TheTesla/LT3060module/LT3060boardTEST/LT3060boardTEST.kicad_pcb

## KiCad design LT3060boardTEST/LT3060boardTEST.kicad_pcb (2014-09-18)

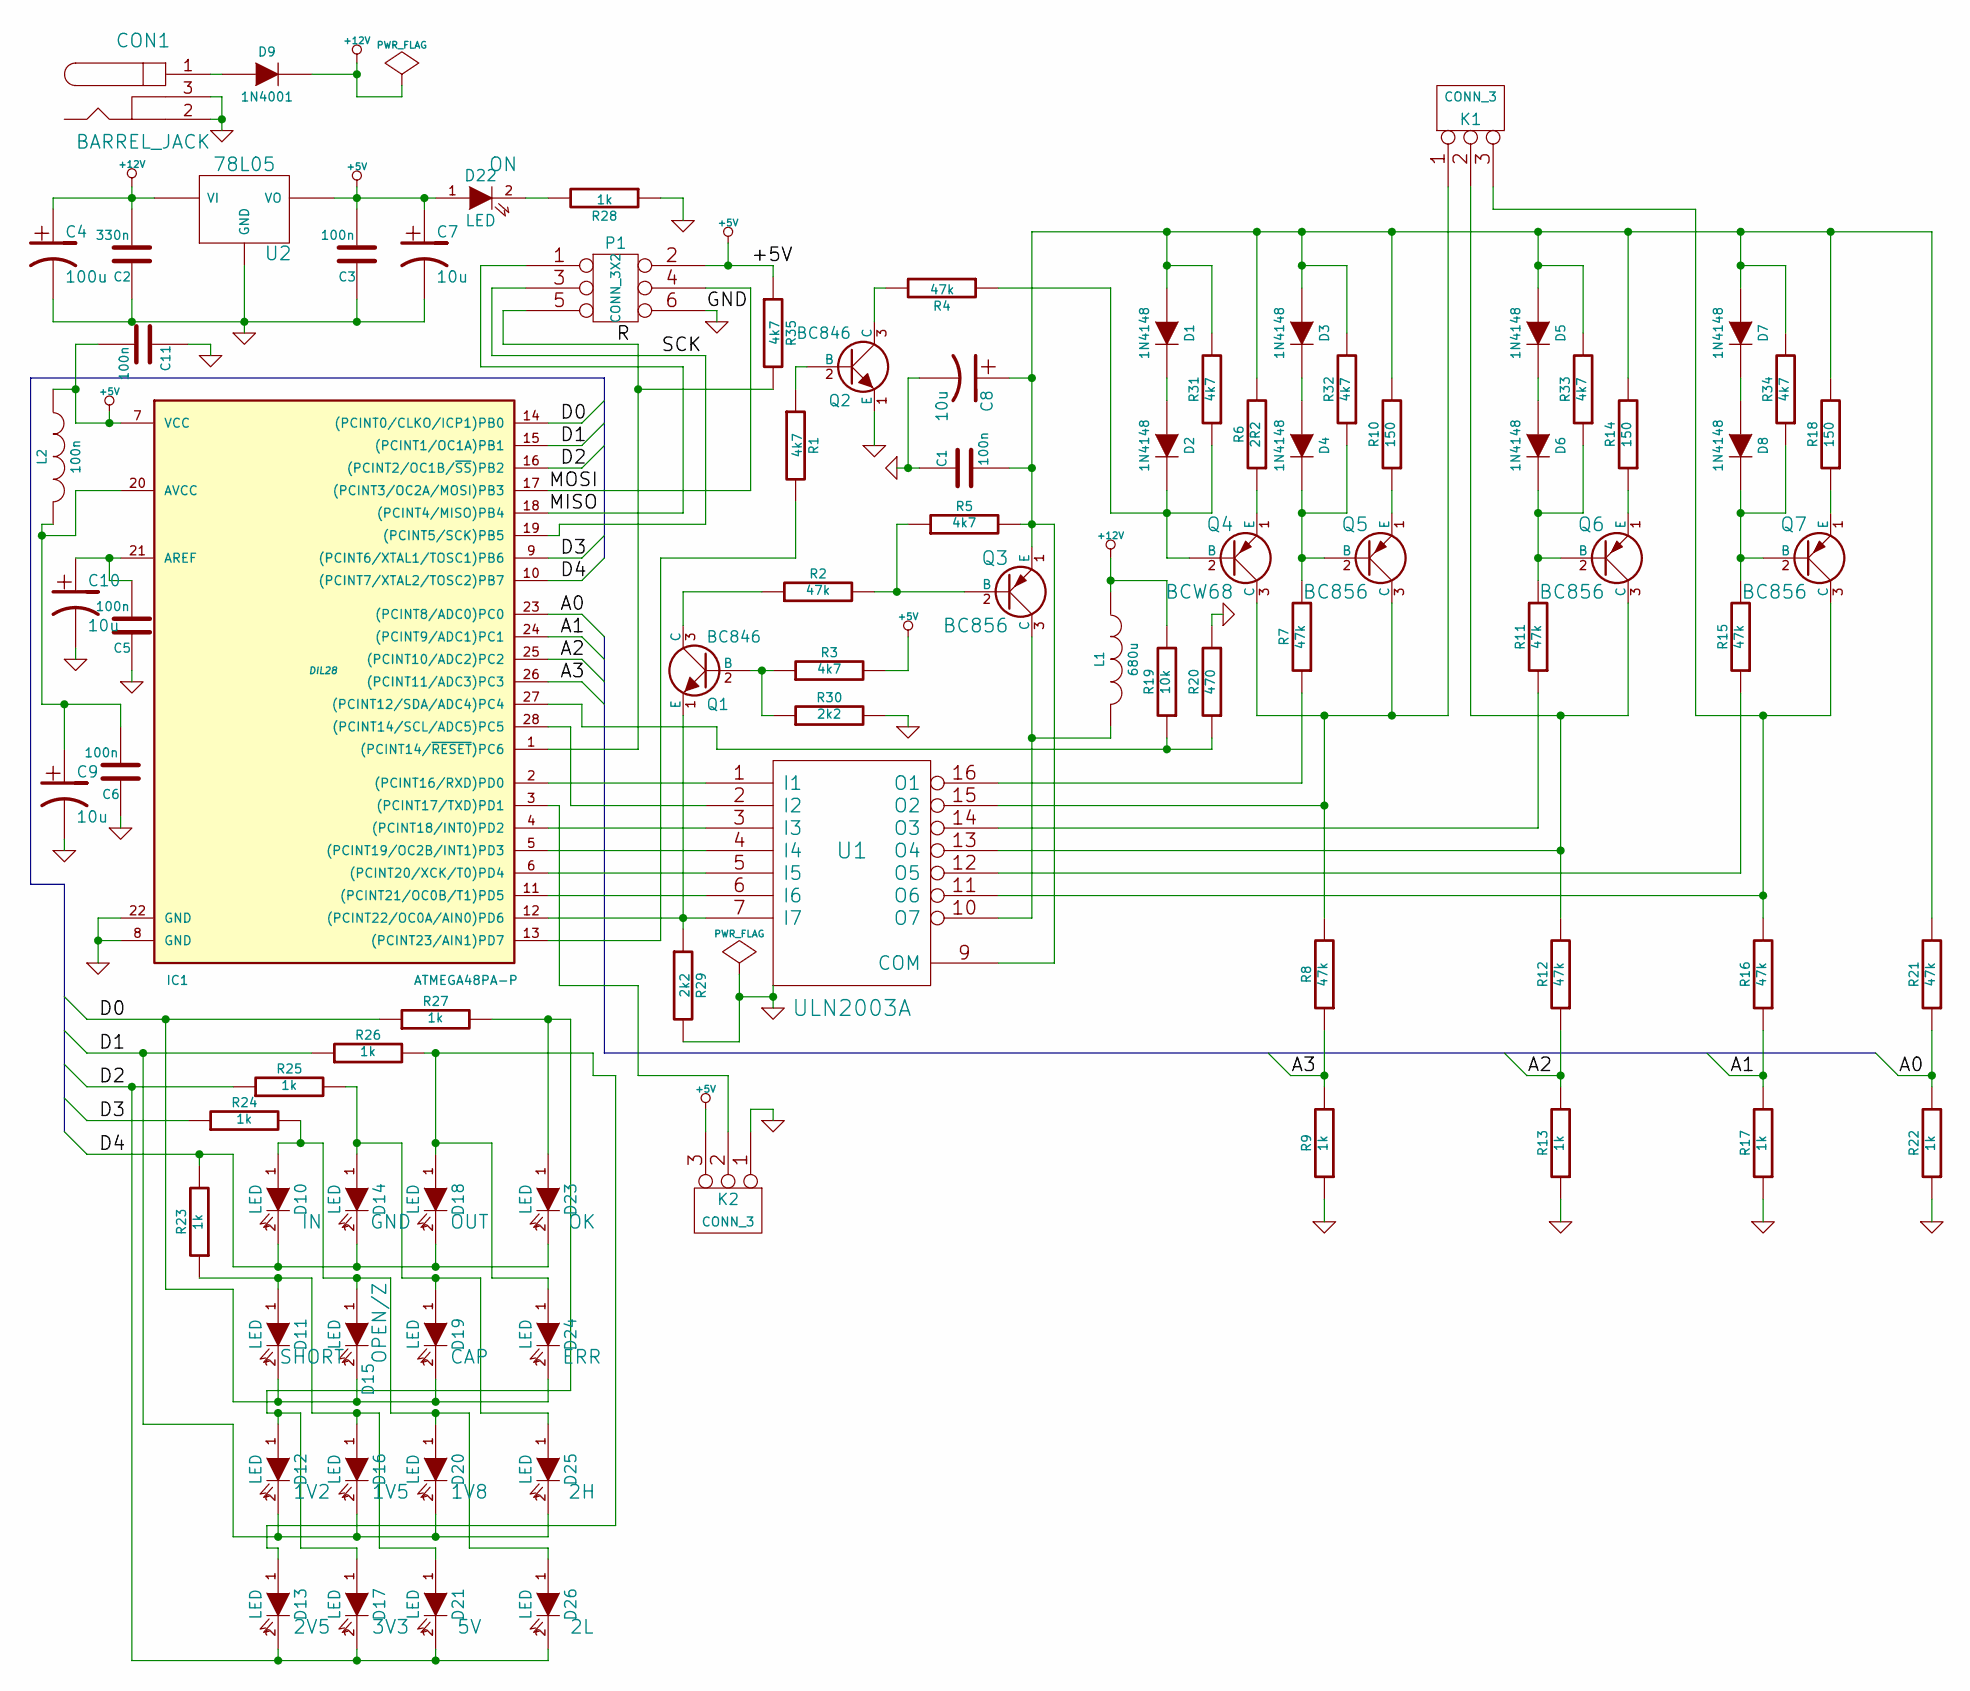
[picture p1: schematic LT3060boardTEST.sch]

Parts:
C1: 100n; Voltage 63
C2: 330n
C3, C5, C6, C11: 100n
C4: 100u
C7, C9, C10: 10u
C8: 10u; Voltage 63
CON1: BARREL_JACK
D1, D2, D3, D4, D5, D6, D7, D8: 1N4148
D9: 1N4001
D10, D11, D12, D13, D14, D15, D16, D17, D18, D19, D20, D21, D22, D23, D24, D25, D26: LED
IC1: ATMEGA48PA-P; DIL28
K1, K2: CONN_3
L1: 680u
L2: 100n
P1: CONN_3X2
Q1, Q2: BC846
Q3, Q5, Q6, Q7: BC856
Q4: BCW68
R1, R3, R5, R31, R32, R33, R34, R35: 4k7
R2, R4, R7, R8, R11, R12, R15, R16, R21: 47k
R6: 2R2
R9, R13, R17, R22, R23, R24, R25, R26, R27, R28: 1k
R10, R14, R18: 150
R19: 10k
R20: 470
R29, R30: 2k2
U1: ULN2003A
U2: 78L05

Connections:
+5V: C3.2, C7.1, C11.2, D22.1 (A), IC1.7 (VCC), K2.3, L2.1, P1.2, R3.2, R35.1, U2.VO
+12V: C2.2, C4.1, D9.2 (K), L1.1, R19.2, U2.VI
/A0: IC1.23 ((PCINT8/ADC0)PC0), R21.1, R22.2
/A1: IC1.24 ((PCINT9/ADC1)PC1), R16.1, R17.2
/A2: IC1.25 ((PCINT10/ADC2)PC2), R12.1, R13.2
/A3: IC1.26 ((PCINT11/ADC3)PC3), R8.1, R9.2
/D0: D11.2 (K), D15.2 (K), D19.2 (K), D24.2 (K), IC1.14 ((PCINT0/CLKO/ICP1)PB0), R27.1
/D1: D12.2 (K), D16.2 (K), D20.2 (K), D25.2 (K), IC1.15 ((PCINT1/OC1A)PB1), R26.1
/D2: D13.2 (K), D17.2 (K), D21.2 (K), D26.2 (K), IC1.16 ((PCINT2/OC1B/~SS~)PB2), R25.1
/D3: IC1.9 ((PCINT6/XTAL1/TOSC1)PB6), R24.1
/D4: D10.2 (K), D14.2 (K), D18.2 (K), D23.2 (K), IC1.10 ((PCINT7/XTAL2/TOSC2)PB7), R23.2
/MISO: IC1.18 ((PCINT4/MISO)PB4), P1.1
/MOSI: IC1.17 ((PCINT3/OC2A/MOSI)PB3), P1.4
/R: IC1.1 ((PCINT14/~RESET~)PC6), P1.5, R35.2
/SCK: IC1.19 ((PCINT5/SCK)PB5), P1.3
GND: C1.1, C2.1, C3.1, C4.2, C5.1, C6.1, C7.2, C8.2, C9.2, C10.2, C11.1, CON1.2, CON1.3, IC1.8 (GND), IC1.22 (GND), K2.1, P1.6, Q2.1 (E), R9.1, R13.1, R17.1, R20.2, R22.1, R28.1, R29.2, R30.2, U1.8 (GND), U2.GND
unnamed: D11.1 (A), D16.1 (A), D21.1 (A), R23.1
unnamed: D13.1 (A), D18.1 (A), D24.1 (A), R26.2
unnamed: D14.1 (A), D19.1 (A), D25.1 (A), R25.2
unnamed: D10.1 (A), D15.1 (A), D20.1 (A), D26.1 (A), R24.2
unnamed: IC1.27 ((PCINT12/SDA/ADC4)PC4), R19.1, R20.1
unnamed: D12.1 (A), D17.1 (A), D23.1 (A), R27.2
unnamed: IC1.3 ((PCINT17/TXD)PD1), K2.2 (PM)
unnamed: C5.2, C10.1, IC1.21 (AREF)
unnamed: IC1.28 ((PCINT14/SCL/ADC5)PC5), U1.2 (I2)
unnamed: C6.2, C9.1, IC1.20 (AVCC), L2.2
unnamed: CON1.1, D9.1 (A)
unnamed: D22.2 (K), R28.2
unnamed: IC1.2 ((PCINT16/RXD)PD0), U1.1 (I1)
unnamed: IC1.13 ((PCINT23/AIN1)PD7), R1.2
unnamed: Q3.2 (B), R2.2, R5.1
unnamed: Q1.3 (C), R2.1
unnamed: D2.2 (K), Q4.2 (B), R4.1, R31.1
unnamed: IC1.4 ((PCINT18/INT0)PD2), U1.3 (I3)
unnamed: IC1.5 ((PCINT19/OC2B/INT1)PD3), U1.4 (I4)
unnamed: IC1.6 ((PCINT20/XCK/T0)PD4), U1.5 (I5)
unnamed: IC1.11 ((PCINT21/OC0B/T1)PD5), U1.6 (I6)
unnamed: Q1.2 (B), R3.1, R30.1
unnamed: D5.2 (K), D6.1 (A)
unnamed: D7.2 (K), D8.1 (A)
unnamed: Q4.1 (E), R6.1
unnamed: D1.2 (K), D2.1 (A)
unnamed: Q2.2 (B), R1.1
unnamed: Q2.3 (C), R4.2
unnamed: D8.2 (K), Q7.2 (B), R15.2, R34.1
unnamed: R7.1, U1.16 (O1)
unnamed: D6.2 (K), Q6.2 (B), R11.2, R33.1
unnamed: R11.1, U1.14 (O3)
unnamed: R15.1, U1.12 (O5)
unnamed: Q5.1 (E), R10.1
unnamed: Q6.1 (E), R14.1
unnamed: C1.2, C8.1, D1.1 (A), D3.1 (A), D5.1 (A), D7.1 (A), Q3.1 (E), R5.2, R6.2, R10.2, R14.2, R18.2, R21.2, R31.2, R32.2, R33.2, R34.2, U1.9 (COM)
unnamed: Q7.1 (E), R18.1
unnamed: D3.2 (K), D4.1 (A)
unnamed: K1.3, Q7.3 (C), R16.2, U1.11 (O6)
unnamed: K1.2 (PM), Q6.3 (C), R12.2, U1.13 (O4)
unnamed: K1.1, Q4.3 (C), Q5.3 (C), R8.2, U1.15 (O2)
unnamed: L1.2, Q3.3 (C), U1.10 (O7)
unnamed: IC1.12 ((PCINT22/OC0A/AIN0)PD6), Q1.1 (E), R29.1, U1.7 (I7)
unnamed: D4.2 (K), Q5.2 (B), R7.2, R32.1

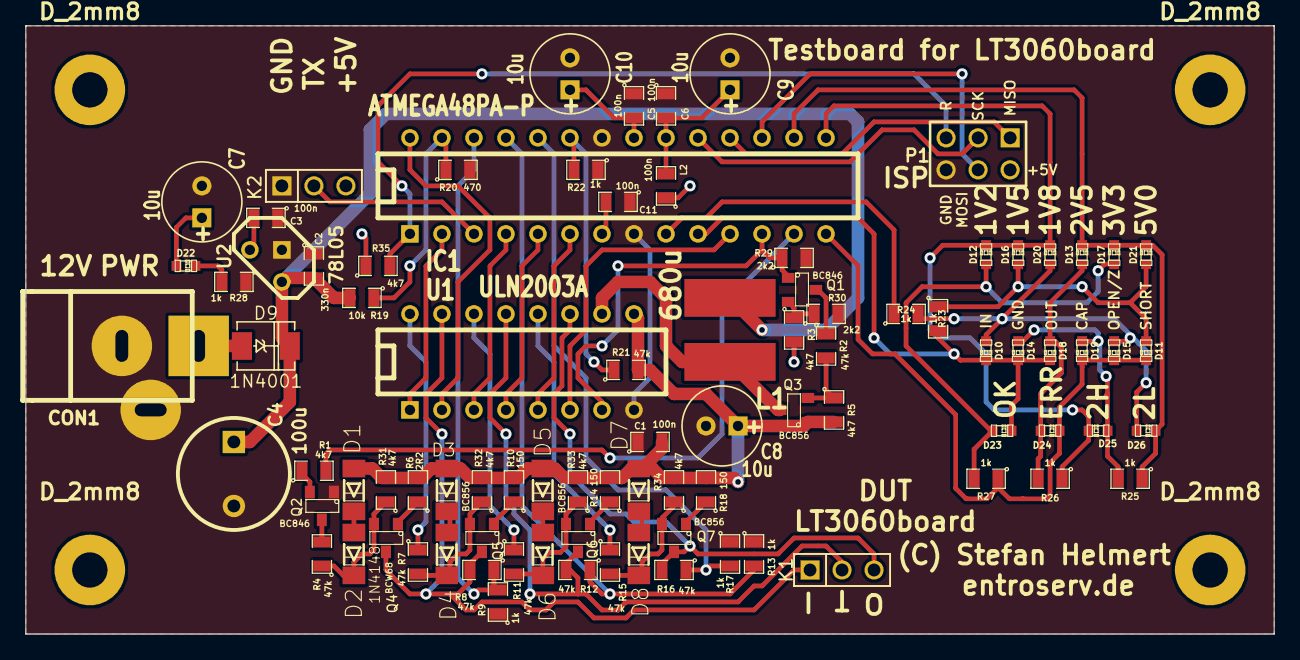
[picture p2: board LT3060boardTEST.kicad_pcb from above]

Board: 2 copper layers, 99.1 x 48.3 mm, 92 parts (0 on the bottom side), 60 nets.

Other parts of the board:
D_2mm8, D_2mm8#2, D_2mm8#3, D_2mm8#4: VAL**; SOLEIL-D_2mm8
