TheTesla/LT3060module/LT3060board.kicad_pcb

## KiCad design LT3060board.kicad_pcb (2014-08-28)

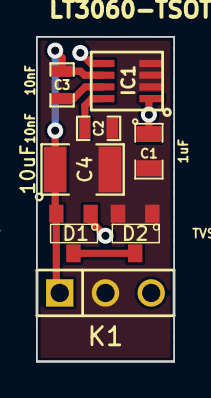
[picture p3: board LT3060board.kicad_pcb from above]

Board: 2 copper layers, 7.6 x 18.0 mm, 8 parts (0 on the bottom side), 6 nets.

Parts:
C1: 1uF; SM0805
C2, C3: 10nF; SM0603_Capa
C4: 10uF; SM1210
D1, D2: TVSCOMA; SOT23
IC1: LT3060-TSOT; tsot23-8
K1: CONN_3; PIN_ARRAY_3X1

Connections:
/Vin: C1.1, D1.1, IC1.1, IC1.5, K1.3
/Vout: C3.1, C4.1, D1.2, IC1.6, K1.1
GND: C1.2, C2.2, C4.2, D2.1, D2.2, IC1.2, IC1.3, IC1.4, K1.2
unnamed: C2.1, IC1.8
unnamed: C3.2, IC1.7
unnamed: D1.3, D2.3
