TheTesla/LT3060module/(commit log)

2014-08-03 Schematic, layout ready
    [Capacitors.csv, LT3060board.kicad_pcb, LT3060board.sch, LT3060board_out.sch]
2014-08-03 more nice
    [LT3060board.GBL, LT3060board.GBO, LT3060board.GBS, LT3060board.GKO, LT3060board.GTL, LT3060board.GTO, LT3060board.GTS, LT3060board.XLN]
2014-08-27 Version with 3 TVS-diodes for protection.
    [LT3060board.GBL, LT3060board.GBO, LT3060board.GBS, LT3060board.GKO, LT3060board.GTL, LT3060board.GTO, LT3060board.GTS, LT3060board.XLN]
2014-08-27 little changes in silkscreen
    [LT3060board-B_Cu.gbl, LT3060board-B_Mask.gbs, LT3060board-B_SilkS.gbo, LT3060board-Edge_Cuts.gbr, LT3060board-F_Cu.gtl, LT3060board-F_Mask.gts, LT3060board-F_SilkS.gto, LT3060board.drl]
2014-08-27 just forgot to run ./rename.sh
    [LT3060board.GBL, LT3060board.GBO, LT3060board.GBS, LT3060board.GKO, LT3060board.GTL, LT3060board.GTO, LT3060board.GTS, LT3060board.XLN]
2014-08-27 edited edge cuts
    [LT3060board.GBL, LT3060board.GBO, LT3060board.GBS, LT3060board.GKO, LT3060board.GTL, LT3060board.GTO, LT3060board.GTS, LT3060board.XLN]
2014-08-28 LT3060 protected by more compact TVS-diodes
    [LT3060board.GBL, LT3060board.GBO, LT3060board.GBS, LT3060board.GKO, LT3060board.GTL, LT3060board.GTO, LT3060board.GTS, LT3060board.XLN]
2014-09-18 Testboard ready - first version of produced Testboard
    [LT3060board-B_Cu.gbl, LT3060board-B_Mask.gbs, LT3060board-B_SilkS.gbo, LT3060board-Edge_Cuts.gbr, LT3060board-F_Cu.gtl, LT3060board-F_Mask.gts, LT3060board-F_SilkS.gto, LT3060board.drl]
2015-07-05 test useable (z-diode test, cap test, voltage test) - no over current test
    [43120434.csv, LT3060board.sch, LT3060board_out.sch, LT3060board_out_digikey_digikey.csv]
2015-07-15 check test board step up regulator, priority of test board self test errors; LT3060boards for other voltages (silk screen); test instruction manual
    [LT3060board_1V2.GBL, LT3060board_1V2.GBO, LT3060board_1V2.GBS, LT3060board_1V2.GKO, LT3060board_1V2.GTL, LT3060board_1V2.GTO, LT3060board_1V2.GTS, LT3060board_1V2.XLN]
